Cambridge-Hackspace/spaces-toolguard-device/hardware/carrier/carrier.kicad_pcb

## KiCad design hardware/carrier/carrier.kicad_pcb (2026-11-12)

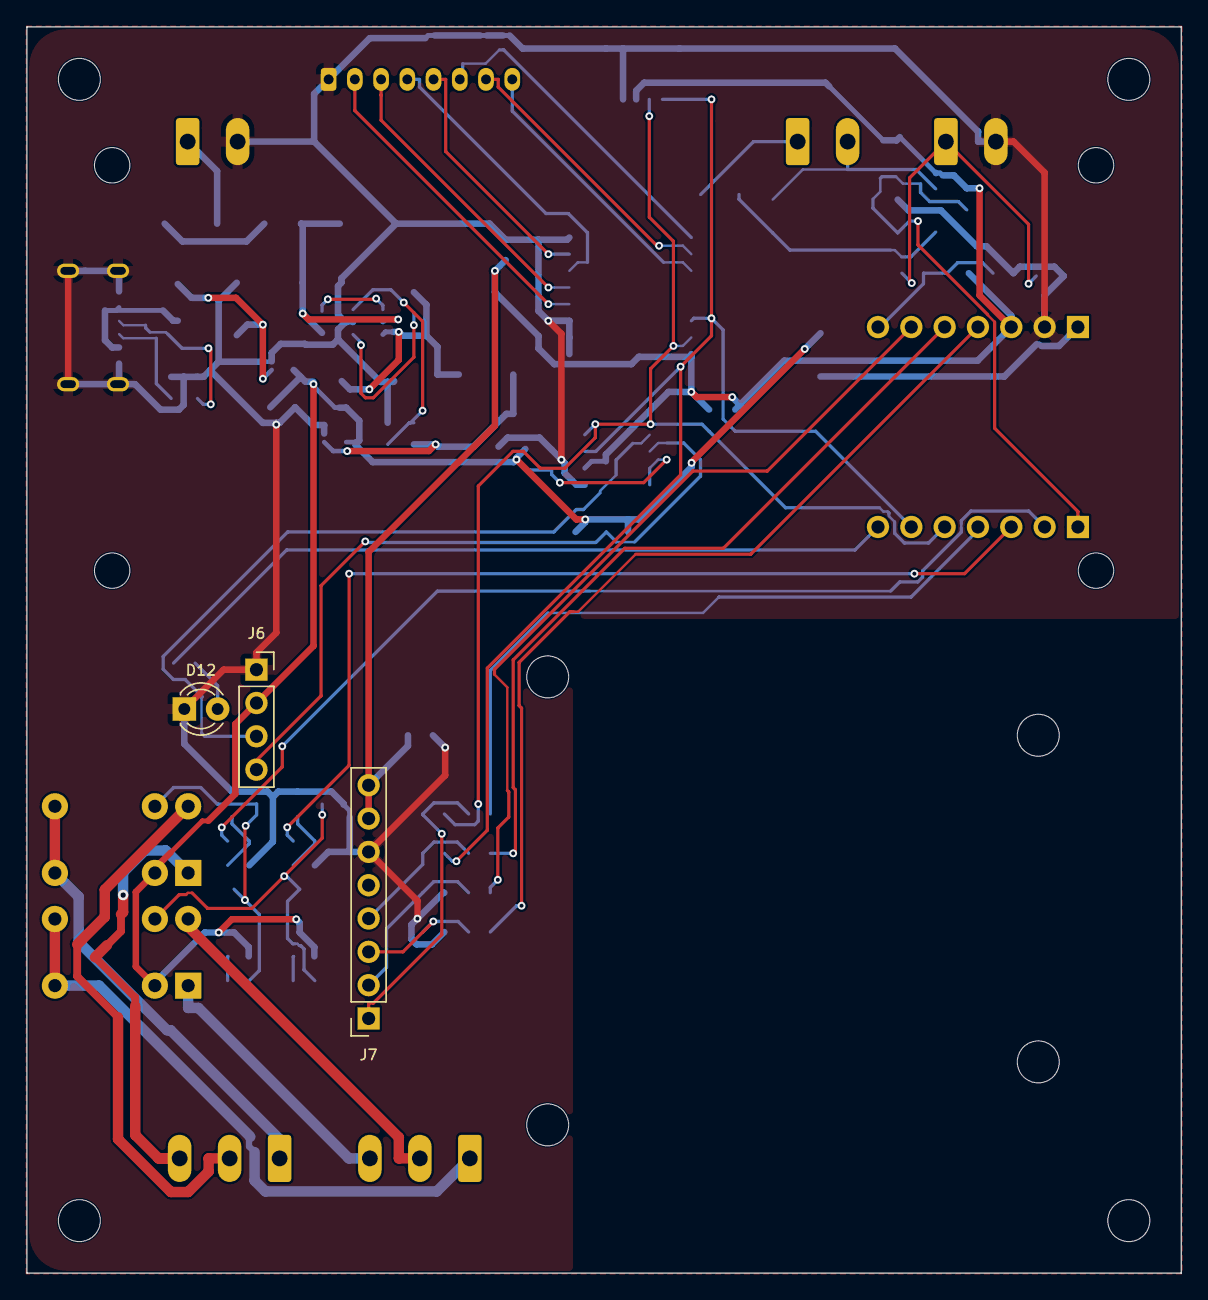
[picture p3: board carrier.kicad_pcb from above]

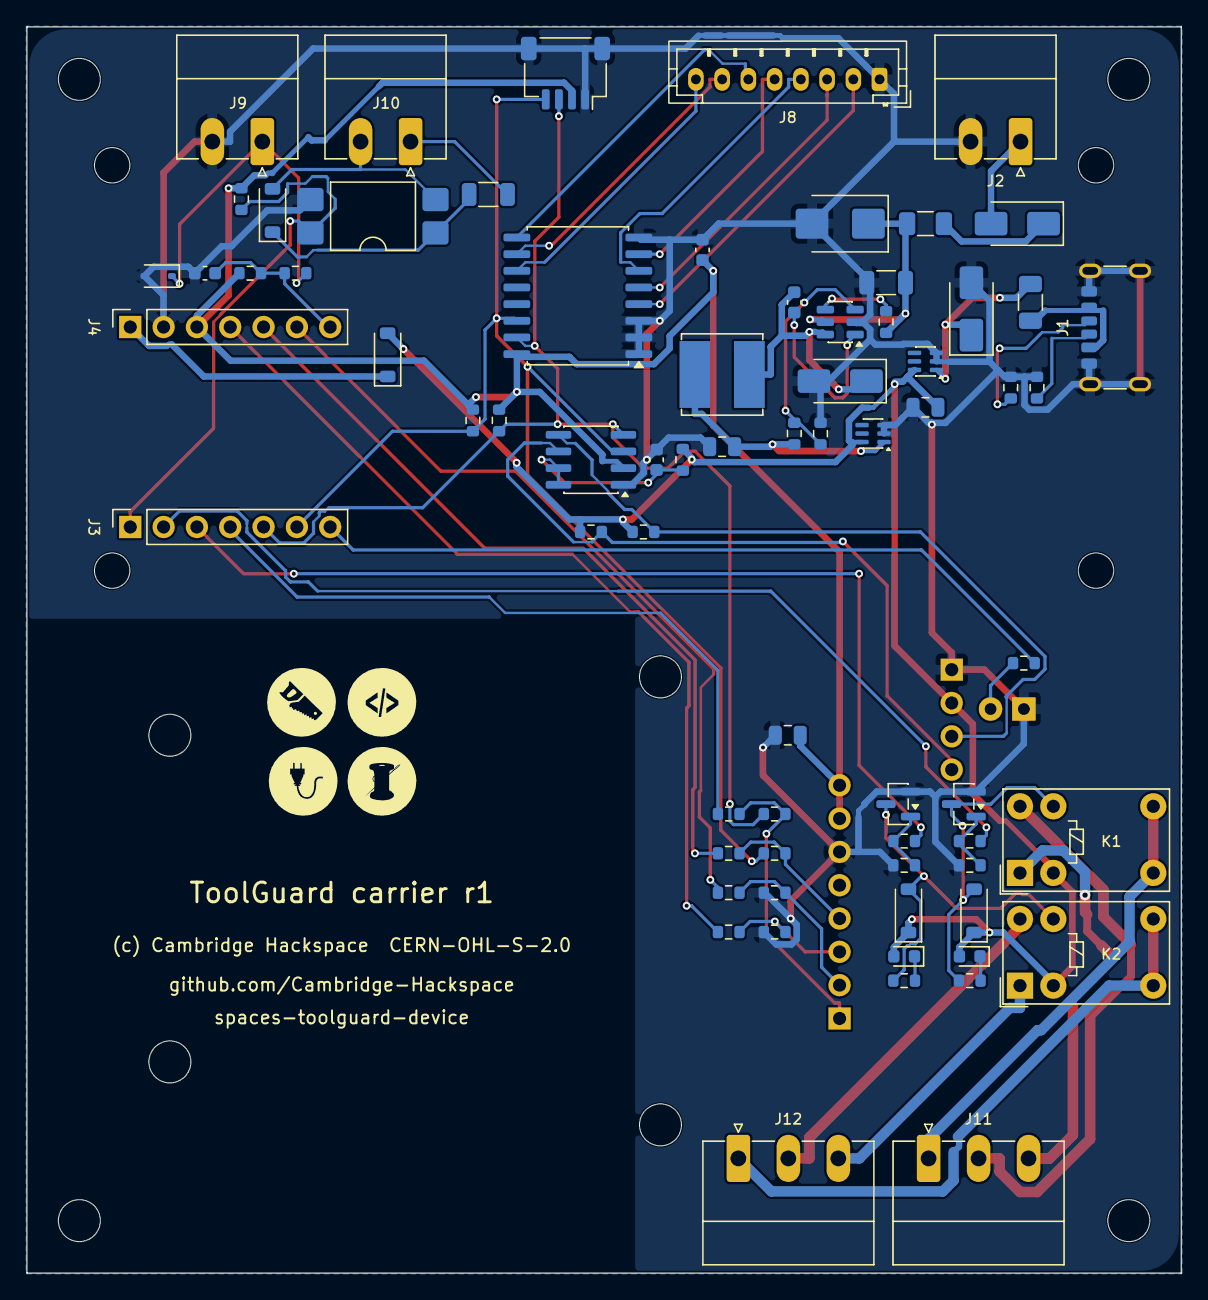
[picture p4: board carrier.kicad_pcb from below]

Board: 2 copper layers, 88.0 x 95.0 mm, 86 parts (71 on the bottom side), 58 nets.

Parts:
C1: 2.2uF 100V; C_1206_3216Metric
C2, C5, C7, C8: 100nF; C_0603_1608Metric
C3: 10uF 16V; C_0805_2012Metric
C4, C6: 10uF 10V; C_0805_2012Metric
D1: 5V standoff; D_SMA
D2, D4: 100V 1A; D_SMA
D3: 40V standoff; D_SMB
D5: 40V 1A; D_SOD-123
D6: 3.3V ESD; D_SOD-323
D7, D8, D10: 1N4148W; D_SOD-123
D9, D11: green; LED_0603_1608Metric
D12: red, 3 mm; LED_D3.0mm
F1: 1.1A hold, 6V+; Fuse_1206_3216Metric
F2: 500mA 63V; Fuse_1206_3216Metric
H1, H2, H3, H4, H9, H10, H11, H12: MountingHole; MountingHole_3.2mm_M3
H5, H6, H7, H8: MountingHole; MountingHole_2.7mm_M2.5
J1: USB_C_Receptacle_PowerOnly_6P; USB_C_Receptacle_GCT_USB4125-xx-x_6P_TopMnt_Horizontal
J2, J9, J10: Conn_01x02; PhoenixContact_MC_1,5_2-G-3.81_1x02_P3.81mm_Horizontal
J3, J4: Conn_01x07; PinSocket_1x07_P2.54mm_Vertical
J5: Conn_01x04_MountingPin; JST_SH_SM04B-SRSS-TB_1x04-1MP_P1.00mm_Horizontal
J6: Conn_01x04; PinSocket_1x04_P2.54mm_Vertical
J7: Conn_01x08; PinSocket_1x08_P2.54mm_Vertical
J8: Conn_01x08; JST_PH_B8B-PH-K_1x08_P2.00mm_Vertical
J11, J12: Conn_01x03; PhoenixContact_MC_1,5_3-G-3.81_1x03_P3.81mm_Horizontal
K1, K2: G5V-1; Relay_SPDT_Omron_G5V-1
L1: 22uH, Isat >= 1.6A; L_Bourns_SRN6045TA
Q1, Q2: AO3400A; SOT-23
R1, R2: 5.1k; R_0603_1608Metric
R3, R24, R27: 100k; R_0603_1608Metric
R4: 57.6k 1%; R_0603_1608Metric
R5: 10k 1%; R_0603_1608Metric
R6, R7, R9, R10: 4.7k; R_0603_1608Metric
R8: 200k; R_0603_1608Metric
R11, R12, R13, R14, R15, R16, R17, R18: 0R; R_0603_1608Metric
R19, R29: 1k; R_0603_1608Metric
R20, R22: 10k; R_0603_1608Metric
R21: 2.2k; R_1206_3216Metric
R23, R26: 100R; R_0603_1608Metric
R25, R28: 2.2k; R_0603_1608Metric
U1: LV2862XDDC; SOT-23-6
U2, U3: LM66100DCK; SOT-363_SC-70-6
U4: PCA9306; SOIC-8_3.9x4.9mm_P1.27mm
U5: PCF8574T; SOIC-16W_7.5x10.3mm_P1.27mm
U6: LTV-817S; SMDIP-4_W9.53mm

Connections:
+3V3: C6.1, C7.1, J4.3, J5.2, J7.7, J7.8, R6.2, R7.2, R20.2, R22.2, U4.2, U5.16
+5V: C4.1, D5.2, D8.1, D9.2, D10.1, D11.2, J6.2, K1.2, K2.2, R8.2, R9.2, R10.2, U2.6, U3.6
+5V2_BUCK: C3.1, L1.2, R4.1, U3.1
BUCK_FB: R4.2, R5.1, U1.3
BUCK_SW: C2.2, D4.1, L1.1, U1.6
CS: J3.4, R15.2
GND: C1.2, C3.2, C4.2, C5.2, C6.2, C7.2, C8.2, D1.2, D3.2, D4.2, D6.2, D12.1, J1.A12, J1.B12, J1.SH, J2.2, J4.2, J5.1, J5.MP, J6.1, J7.6, J8.1, J9.2, Q1.2, Q2.2, R1.2, R2.2, R5.2, R13.2, R14.2, R24.2, R27.2, U1.2, U2.2, U2.3, U3.2, U3.3, U4.1, U5.1, U5.2, U5.3, U5.8, U6.3
JOY_DOWN: J8.3, U5.5
JOY_LEFT: J8.4, U5.6
JOY_MID: J8.6, U5.9
JOY_RIGHT: J8.5, U5.7
JOY_RST: J8.8, U5.11
JOY_SET: J8.7, U5.10
JOY_UP: J8.2, U5.4
K1_COIL: D8.2, K1.9, Q1.3, R25.2
K1_COM: J11.1, K1.5, K1.6
K1_GATE: Q1.1, R23.2, R24.1
K1_LED: D9.1, R25.1
K1_NC: J11.3, K1.1
K1_NO: J11.2, K1.10
K2_COIL: D10.2, K2.9, Q2.3, R28.2
K2_COM: J12.1, K2.5, K2.6
K2_GATE: Q2.1, R26.2, R27.1
K2_LED: D11.1, R28.1
K2_NC: J12.3, K2.1
K2_NO: J12.2, K2.10
LIGHT: J3.7, R29.1
LVL_EN: C5.1, R8.1, U4.7, U4.8
MISO: J4.5, R16.2
MOSI: J4.4, R18.2
unnamed: J1.A5, R1.1
unnamed: J1.B5, R2.1
unnamed: R3.2, U1.4
unnamed: C2.1, U1.1
unnamed: D12.2, R29.2
RC_MISO: J7.4, R12.1, R16.1
RC_MOSI: J7.3, R14.1, R18.1
RC_SCK: J7.2, R13.1, R17.1
RC_SDA: J7.1, R11.1, R15.1
RELAY: J3.2, R23.1
SCL: J3.6, J5.4, R7.1, R12.2, U4.3, U5.14
SCLK: J4.6, R17.2
SCL_5V: J6.4, R10.1, U4.6
SDA: J3.5, J5.3, R6.1, R11.2, U4.4, U5.15
SDA_5V: J6.3, R9.1, U4.5
SENSE: J3.1, R22.1, U6.4
SENSE_LED: D7.1, R21.2, U6.1
SENSE_N: D7.2, J10.2, U6.2
SENSE_P: J10.1, R21.1
STOP: C8.1, J4.7, R19.2, R20.1
STOP_IN: D6.1, J9.1, R19.1
STRIKE: J3.3, R26.1
VBUS: F1.1, J1.A9, J1.B9
VBUS_F: D1.1, F1.2, U2.1
VIN: C1.1, D3.1, F2.2, R3.1, U1.5
VIN_RAW: D2.2, J2.1
VIN_RP: D2.1, F2.1
XIAO_5V: D5.1, J4.1
