Cambridge-Hackspace/spaces-toolguard-device/(commit log)

2026-11-07 the ESP32-C5 as a compile-only target (#15)
    Same family and triple as the C6 -- riscv32imac-esp-espidf, plain upstream
    nightly, ESP-IDF v5.5.3, which this repo already pins -- with the one
    difference that matters in a hackspace: 5 GHz Wi-Fi. Every tool box on
    2.4 GHz is another talker in the band the Zigbee mesh shares; a C5 box is out
    of that contest. It also has more GPIO than the C6, though the pin map below
    spends all of it on the DevKitC-1.
    The C5 gets the standing the C3 and S3 have: a cfg-gated pin map, a
    check-cfg entry, a board::CHIP arm, a CI matrix row that lints and builds
    it, a column in the documented pin table, and the README's build line.
    THE TRIPLE IS THE C6's. embuild map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
2026-11-08 an update waits while anything is open
    spaces-device-espidf refuses a firmware update while a session is open, but
    only when the firmware says so, and this one never did: it drives its own
    loop over Reader rather than spaces-device-espidf's run(), which is where
    set_in_session is called. So a push could restart a box mid-cut, dropping
    the tool's power on a box that switches it, and the box came back up knowing
    nothing of the session it had opened.
    The core now says when something is open or nothing is, as
    Action::InSession, emitted on change, and the firmware hands it to the
    update guard. "Open" is a question out to the edge, a session, or the tool
    output on. The last is what a plug has, si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
2026-11-08 an update has to get back to the broker, or it is undone
    A new image is on probation until it gets back to what the old one had, and
    the broker is one of those milestones. spaces-device-espidf reaches and
    loses it only in its own run(), which this firmware does not use, so no
    image of it ever reached the broker as far as the update guard knew. An
    image that joined Wi-Fi but never reached the edge's broker passed
    probation, where it should have been rolled back after three minutes.
    The loop now reaches update::BROKER on every connect and loses it on every
    disconnect, as run() does.
    Wiring in main.rs only: the core is not involved, and the firmware crate
    builds only for an ESP target, so the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
    [main.rs]
2026-11-08 the outputs are driven low before anything else
    The relay and strike pins were opened, and driven low, only after boot()
    returned: after Wi-Fi had joined and the device had registered, and never
    while the setup portal was open. Until then each was an input at its reset
    state, floating or weakly pulled, and a relay driver that reads a floating
    input as on could energize the tool, or release a door, for seconds or
    indefinitely.
    Both are now opened and driven low first, whatever the settings say. An
    output the settings do not use keeps its driver held all the same, since
    dropping it resets the pin and lets it float again; the settings still
    decide which of them the core may drive.
    On the C3 t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
    [main.rs]
2026-11-08 a broker that cannot be set up restarts the box, as other failures do
    broker::connect failing returned from main with `?`. That ends the program
    but not the board: it stayed on the network serving updates, with nothing
    reading cards, sending heartbeats or drawing the panel, and nothing saying
    why. Every other fatal path logged, set the light to failed, waited thirty
    seconds and restarted.
    They all go through give_up() now, which also puts a screen up when there is
    a panel: "Broker failed / see /log" for this one, "Reader fault" as before
    for the RC522. A blank broker address cannot get this far, since the shared
    setup fields require it; a malformed one can, and now restarts every thirty
    sec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
    [main.rs]
2026-11-08 the panel knows when Wi-Fi is gone
    health() always said Wi-Fi was up, on the reasoning that boot() does not
    return until it has joined. True at boot; but when the network went later,
    the broker dropped with it and the diagnostic screen said "No edge", naming
    the wrong half -- the screen exists to say which half is missing.
    The firmware now listens for the station joining and losing its network on
    the system event loop, and feeds that into the loop's channel beside the
    broker's events, so the panel is told both in the order they happen. If the
    subscription cannot be made, it says so in the log and assumes Wi-Fi is up,
    as before.
    The fix is wiring in main.rs and broker.rs, which build only f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
    [main.rs, reader.rs]
2026-11-08 settings are read in the core, and tested
    What the setup page's words mean was decided in toolguard-fw, which builds
    only for an ESP target, so none of it was tested: what a typo reads as, what
    a blank defaults to, which roles a combination registers, and that a second
    tap defaults on only where nothing else can stop a session. It is pure code
    over strings, so it moves to toolguard_core::settings and reads through a
    lookup. The firmware keeps the setup page's fields and reads the store;
    anything that could not be read comes back as warnings for it to log, since
    the core has no logger.
    One bug found on the way: "Bridge gaps" and "Ignore blips" were cast to u32
    with `as`, so a large enough va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
    [lib.rs, main.rs, settings.rs]
2026-11-08 a box says when its roles changed after registration
    The roles are derived from the settings and sent once, at registration; a
    registered device never sends them again. So changing "Has a card reader",
    "Switches the tool", "Senses the machine" or "Drives a latch" on a working
    box changed what it did and not what the platform had it as: a reader told
    it now switches the tool drove its relay, could never be bound in `power`,
    and was never leased, with nothing to say why.
    The firmware now records the roles under reg_roles whenever it knows they
    have just been sent (a box registering on this boot) and compares them at
    every later boot. If the settings claim different roles, it says so in the
    lo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
2026-11-08 the panel is sent only what it can draw
    A screen cut each line to sixteen characters and left what an HD44780
    cannot render to the shell, which printed it as it was. A reason with an em
    dash, a curly quote or an accent went to the panel as its UTF-8 bytes, each
    drawn as whatever the character ROM holds there: garbage, and more columns
    of it than the line had characters.
    Each character is now mapped before the cut: printable ASCII from space to
    `}` stands, except `\` and `~`, which the common A00 ROM draws as a yen sign
    and an arrow; everything else is a `?`. A line is then plain ASCII, so
    sixteen characters is sixteen columns.
    Tests: accents, an em dash and a curly quote each become one `?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
2026-11-08 how usage is measured is a setting, in the core
    The sense input was one thing: a level, active low or high, read once a
    pass. On the laser that is wrong two ways, and the core now has the pieces
    to get both right; the firmware is wired to them in the next commit.
    - Firing on L-ON1 is pulses of a few milliseconds (#9). Read once every
    75 ms, most are never seen. Usage measured by "pulses" counts a pass as
    working if the input is asserted or pulsed at all since the last read,
    which the firmware is to latch by interrupt. The blip and gap filters stay
    downstream and unchanged, so a run of pulses is joined into one stretch and
    a lone glitch under the blip filter is still rejected.
    - Wi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
    [lib.rs, reader.rs, sense.rs, settings.rs]
2026-11-08 the firmware measures usage as configured: pulses by interrupt, and a powered input
    The firmware half of the previous commit.
    - Pulses (#9): with "Usage measured by" pulses, the sense pin gets an
    interrupt on the edge into its asserted level, which only sets an atomic.
    The loop takes the flag each pass, re-arms the interrupt (the driver
    disables it each time it fires), and hands the core a Reading: asserted
    now, pulsed since the last pass, and the powered input if there is one.
    A pulse of a millisecond between two 75 ms passes is no longer lost.
    - A powered input (#8), on GPIO7 on the C6 (an edge pin on the Super Mini,
    not strapping, and clear of the ADC pins an analog source wo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
    [main.rs, settings.rs]
2026-11-09 spaces-firmware v0.8.0: the shared loop and CS:S's wire, no change in behaviour (#18)
    From v0.4.0 to v0.8.0 of spaces-device and spaces-device-espidf: the device
    trait and shared loop (v0.7.0), and the wire as CS:S's css_wire (v0.8.0).
    This box keeps its own loop for now; moving onto run() is the next commits.
    The one test fix is the reply shape: css_wire requires `reason`, and the
    door test's strike reply lacked it, so it no longer parsed and read as a no.
    77 core tests, clippy (host and C6) and the C6 build pass.
    [reader.rs]
2026-11-09 the box runs on spaces-firmware's loop, and broker.rs is gone (#18)
    This box ran its own copy of the loop in broker.rs, because the library's
    run() drove only a Module, and the copy missed what the library's loop did
    besides -- holding an update during a session, the BROKER milestone, Wi-Fi
    state -- until each was patched back in by hand (#1, #2, #5). With the
    Device trait (spaces-firmware #8) the library's run() drives this box too,
    and does all three once, for every device.
    Core: Reader implements Device, with Input for a card, the stop button, a
    sense reading, the resting-screen notice and the clock. The session is a
    query, Reader::in_session(), instead of an action: Action::InSession is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
    [device.rs, lib.rs, main.rs, reader.rs]
2026-11-09 the stop button uses spaces-device's debouncer (#18)
    toolguard-core's StopButton was a second debouncer beside spaces-device's
    input::Debounced, which every device now shares (spaces-firmware #6). The
    stop button is a Debounced::button(): a press counts once the contact has
    settled for 30 ms, and holds for 250 ms, so no bounce or lingering finger
    is a second stop. StopButton (a 50 ms settle, held until release) and its
    four tests are deleted; Debounced is tested in spaces-device. The README's
    crate table says what toolguard-core now is.
    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
2026-11-09 version 0.3.0, with the tag
    A version bump has no behaviour to test; the core suite was run once more
    at this version so the tag is cut from a green tree.
2026-11-09 spaces-toolguard-device: the repo holds the boards too, under CERN-OHL-S
    The repository is renamed from spaces-toolguard-firmware, because it is
    about to hold the boards the firmware runs on as well as the firmware.
    The pin map has to agree in two places, `board.rs` and a board's
    schematic, and keeping both in one repo means a change to either lands
    in one pull request and a test can hold them together.
    - Cargo.toml's `repository`, the README's title and the boot log line
    take the new name. GitHub redirects the old URLs, so nothing else has
    to move today.
    - hardware/ is new and licensed CERN-OHL-S-2.0. AGPL is a software
    licence and says nothing useful about a board someone manufactur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
2026-11-09 C3: the strike moves off U0TXD, which the boot ROM drives (#20)
    The C3 map put the strike on GPIO21, U0TXD, on the reasoning that the
    Super Mini's console is native USB so UART0 is free. It is not free at
    boot: by default (EFUSE_UART_PRINT_CONTROL = 0) the ROM prints its
    messages on UART0 regardless of the application's console, and the
    ESP32-C3 datasheet (v2.4, table 2-1) lists U0TXD as output-enabled with
    a pull-up after reset. A latch driver there would pulse the door open on
    every power-up, crash and update, before the firmware drives the pin
    low.
    - strike is now GPIO4 (MTMS): input-enabled, no pull at reset, not
    driven by the ROM, so the driver's gate pull-down holds it off.
    - The RC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
    [main.rs, pinmap.rs]
2026-11-09 rc522.rs says exactly which part is GPL-3.0 (#14)
    The header said both that the file was "adapted from" nfc-522's
    src/nfc.rs (GPL-3.0, with a second copyright) and that "what is taken is
    the shape rather than the text", which cannot both be the whole story.
    Compared line by line against nfc-522's nfc.rs: Reader::poll's
    REQA / SELECT / HLTA / STOP-CRYPTO1 sequence and the two comments
    explaining it are close paraphrases of nfc-522's poll(). The rest is
    not: the bring-up, the mode-3 SPI configuration, the version-register
    checks and their diagnostics, and to_hex (same job, different code).
    Probing by version register and the same-UID cooldown are ideas taken
    without the text.
    So the header n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
2026-11-09 Pins, stale comments, and the controller's safety inputs in the docs (#12)
    Pins (checked against the ESP32-C6 datasheet):
    - GPIO4-7 were called "strapping, JTAG and flash-adjacent" and treated
    as unavailable, while the C6 map already uses GPIO7. 4 and 5 are
    strapping pins (MTMS, MTDI), 6 and 7 are JTAG (MTCK, MTDO), and flash
    is GPIO24-30. They are usable with care: nothing driving 4 or 5 at
    reset, and no must-stay-off output on 6, which is pulled up after
    reset. board.rs and INSTALLING.md section 5 say so.
    - "SPI occupies all of ADC1 (GPIO0-6)" was wrong: SPI holds 0-3, so
    4-6 remain, which is where an analog sense input would go (#10).
    - "A C6 Super Mini is full" now says the f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
    [board.rs, main.rs, rc522.rs, screen.rs]
2026-11-09 CI: the Rust cache is keyed by chip, so the C5 job never gets the C6's
    Swatinem/rust-cache keys on the job id, which is `riscv` for every entry
    in the RISC-V matrix, and the C5 and C6 share a target triple. The C5
    job on PR #26 restored a target/ the C6 job had saved, with
    esp-idf-sys's build directory configured for esp32c6, and CMake refused:
    "CMAKE_TOOLCHAIN_FILE 'toolchain-esp32c6' does not match currently
    selected IDF_TARGET 'esp32c5'". Which job saved last decided whether the
    C5 build passed, which is why it passed on earlier PRs.
    `key: ${{ matrix.mcu }}` gives each chip its own cache. The ESP-IDF
    cache (.embuild) was already keyed by chip.
    No test: CI configuration. The proof is thi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
2026-11-09 Pin maps by board, from one TOML file per board (#25, step 1)
    The firmware chose pins by chip (`cfg(esp32c6)` tuples in main.rs), and
    the XIAO carrier and the DevKitC-1 are both C5s. This moves each map to
    toolguard-fw/boards/<board>.toml and chooses the board with `BOARD`, as
    the chip is chosen with `MCU`. No behaviour changes: every board file
    holds exactly the pins its chip had (checked against the old main.rs
    tuples), and each chip's default board is the one it built before.
    - build.rs reads BOARD (default per MCU: c6-supermini, c5-devkitc1,
    c3-supermini, s3-devkitc1), refuses an unknown board, a board for
    another chip, a missing required role, an unknown role, and a GPIO
    named tw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
    [board.rs, build.rs, main.rs, pinmap.rs]
2026-11-09 The XIAO C5 carrier board, with its reader found on I2C (#19, #23)
    The carrier board (#25) takes a socketed Seeed XIAO ESP32-C5, puts the
    LCD, a converted RC522 and the joystick's expander on one I2C bus, wires
    the stop button normally closed and has a plain panel LED. This is the
    firmware for it, on spaces-firmware v0.9.0.
    The shared bus and the reader (#23):
    - bus.rs makes the I2C driver once and hands each part a RefCellDevice
    (embedded-hal-bus); everything on it runs on the loop's one thread.
    - The LCD is found through spaces_device::i2c and initialised AT THE
    ADDRESS IT WAS FOUND: CharacterDisplayPCF8574T::new used the crate's
    default address whatever the scan found, so a backpac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
2026-11-11 The carrier board's schematic, as SKiDL, checked against the firmware (#25)
    hardware/carrier/ is the ToolGuard carrier's schematic: a socketed XIAO
    ESP32-C5 and everything around it, one design populated per box (#24).
    Why SKiDL and not atopile: atopile 0.15 needs a signed-in hosted service
    to pick any part, even one named by LCSC number, and says its CLI is in
    maintenance mode, replaced by a hosted app. A board that only builds
    while logged in to a service is a poor fit for CERN-OHL-S's Complete
    Source. SKiDL (MIT, pinned 3.0.0 in uv.lock) is Python and offline, and
    builds from KiCad 10's own symbol and footprint libraries.
    carrier.py, by block: USB-C power in (power only: 5.1 k on both C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
    [build.rs, carrier.py, check.py]
2026-11-11 carrier: ignore KiCad's per-user files, and say where the layout lives
    The layout (carrier.kicad_pcb) and project (carrier.kicad_pro) go in
    hardware/carrier/ next to carrier.py and carrier.net. KiCad's backups,
    local view state (.kicad_prl), footprint cache and lock files are
    ignored. The README says the empty carrier.kicad_sch KiCad makes stays
    empty: carrier.py is the schematic, and the netlist is the only way it
    reaches the layout.
    No test: ignore rules and documentation.
2026-11-11 carrier: the KiCad project and an empty board, with fab design rules
    carrier.kicad_pro and carrier.kicad_pcb, made through KiCad 10.0.8's own
    Python API (pcbnew) so the settings are KiCad's, not hand-written JSON:
    two copper layers, 1.6 mm, and design rules comfortably inside PCBWay's
    standard 2-layer process -- 0.15 mm minimum track and clearance, 0.3 mm
    minimum drill, 0.6 mm vias with a 0.15 mm annular ring, 0.25 mm hole
    clearance, 0.3 mm copper-to-edge; the default net class 0.25 mm tracks,
    0.2 mm clearance, 0.6/0.3 mm vias.
    The board is empty on purpose: footprints arrive by Import Netlist
    (carrier.net) in the KiCad GUI, which links each to its part by its
    fixed tag. Placing them by scr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
    [carrier.kicad_pcb]
2026-11-11 carrier: every footprint is explicit; the 1N4148Ws are SOD-123
    The first netlist import put three 1N4148W diodes (both relays' flyback
    diodes and the sense input's reverse diode) on through-hole DO-41
    footprints: carrier.py named no footprint for them, and KiCad's 1N4148W
    symbol defaults to D_DO-41 although the part is SOD-123. check.py did
    not catch it -- a DO-41 has pads 1 and 2 too -- and a footprint-filter
    check would not have either: SKiDL's list for the symbol includes the
    DO-41.
    So part() now refuses to make a part without an explicit footprint: a
    symbol's default is not a choice. The diodes are Diode_SMD:D_SOD-123,
    and the opto and relays name the footprints they already had.
    Also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
    [carrier.py]
2026-11-11 carrier: holes for the LCD and the RC522, and a through-hole status LED
    - Four M2.5 holes for the LCD's standoffs (a 1602's holes are usually on
    75 x 31 mm; M2.5 also takes the small-holed variants) and two M3 holes
    for the RC522 module, to be used with nylon standoffs since metal near
    the antenna detunes it. They are in the netlist because the import
    deletes footprints that are not; their positions are the layout's,
    measured against the real modules.
    - The status LED is a 3 mm through-hole part (LED_THT:LED_D3.0mm, pad 1
    K as on the symbol) on the front, so it shows through the panel while
    every SMD part stays on the back for one-sided assembly.
    - The README gains the layout g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
2026-11-12 carrier: the LCD's and the RC522's measured hole patterns
    From caliper measurements of the Hackspace's own modules, centres worked
    out from edge-to-edge gaps: the QAPASS 1602 on 75.0 x 30.9 mm (the
    standard pattern), and the blue RC522's four holes, which assume 3.2 mm
    holes and a level bottom row; the README says how to confirm them. For
    placing the hole footprints in the layout.
    No test: documentation.
2026-11-12 carrier: first placement and routing, DRC clean but for silkscreen
    The first full layout, 88 x 95 mm, done through KiCad 10's Python API
    and Freerouting 2.5.0 (run on Java 27), checked with kicad-cli.
    Front, facing the panel: the LCD across the top on its standoffs
    (75.0 x 30.9 mm), the RC522 landscape at the bottom right with its
    antenna to the right edge, the status LED and the LCD's cable connector
    at the bottom left. Back: field terminals, the joystick and Qwiic
    connectors along the top edge; USB-C power and the buck at the left
    edge; the XIAO socketed at the right edge with its USB-C reachable; the
    I2C parts between; the relays and their drivers above their terminals
    at the bottom. A r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
    [carrier.kicad_pcb]
2026-11-12 carrier: the Cambridge Hackspace logo on the back silkscreen
    The cutout logo (icons only), 14 mm across, above the licence text in
    the RC522 antenna's copper-free area on the back. Added as board
    graphics rather than a footprint: a netlist import deletes footprints
    that are not in the netlist, and never touches board graphics. Its SVG
    paths were flattened, combined so the icons are cut out of their
    circles, and mirrored to read correctly from the back.
    DRC unchanged: 0 unconnected, no errors; the same 46 silkscreen
    warnings as before. The finest strokes (the spool's thread, the saw's
    teeth) are near silkscreen's resolution at this size.
    [carrier.kicad_pcb]
2026-11-12 carrier: a build guide, in Quarto, with figures drawn from the board
    hardware/carrier/guide/ renders to PDF (through Typst) and to a single
    HTML page with `quarto render`. It covers what to fit for each box
    configuration (#24), choosing the reader's I2C or SPI links, the 7-60 V
    input, the through-hole soldering order, the mechanical stack (standoffs,
    nylon for the RC522), the field wiring, building and setting up the
    firmware, and a bring-up checklist. What the installation guide already
    says -- safety, the signal on a Ruida controller, the setup page, the
    platform -- it links to rather than repeats.
    The figures are generated from carrier.kicad_pcb by figures.py: each
    side of the board with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
2026-11-12 CI: KiCad's PPA calls its library packages kicad-symbols and kicad-footprints
    The carrier check's first run failed installing kicad-library-symbols
    and kicad-library-footprints: those are the PPA's source package names;
    apt names the binaries kicad-symbols and kicad-footprints.
    No test: CI configuration; the PR's next run is the proof.
2026-11-12 Carrier: silkscreen clean (DRC 0 violations, was 46 warnings)
    The surface-mount parts' reference labels move to the Fab layers: the fab
    places them from the pick-and-place file, so their labels belong on the
    assembly drawing, not on the copper and each other. Through-hole parts,
    soldered by hand, keep theirs on the silkscreen; the four that collided
    (K1, K2, J9, J10) move to the nearest clear spot.
    Layout-only, no circuit change; DRC is the check (kicad-cli pcb drc: 0
    violations, 0 unconnected). Guide render of the back regenerated.
    [carrier.kicad_pcb]
2026-11-12 Carrier: fab.py writes the order files (Gerbers, drill, BOM, placement)
    Gerbers and drill files, zipped, for the bare board; and per variant a
    BOM in PCBWay's columns, the centroid file, the hand-solder list and the
    not-fitted list. Two variants: usb (every box but (d)) and vin (box (d),
    the 7-60 V input fitted). The SPI reader links are never fitted.
    It works on a copy of the board: the netlist import keeps the schematic's
    DNP as a field but not as KiCad's flag, so the copy gets the flags for its
    variant, and the drill/place origin at the bottom-left corner. The source
    board is unchanged.
    Outputs go to fab/, git-ignored. Checks itself: every fitted part is
    either SMD or THT, and the place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
2026-11-12 Carrier: part numbers for the parts given only by rating
    F1 (polyfuse) Bourns MF-NSMF110-2: 1.1 A hold, 6 V, 1206
    F2 (VIN fuse) Littelfuse 0466.500NR: 500 mA, 63 V AC/DC, 1206
    L1 (buck) Bourns SRN6045TA-220M: 22 uH, Isat 3.3 A (needs 1.6 A);
    the footprint's own series. Not the SRN6045 (no TA): 1.9 A.
    D9, D11 Lite-On LTST-C191KGKT: green 0603, Vf 2.0 V typ, 2.4 V
    max; ~1.3 mA through 2.2k from 5 V
    Set in carrier.py, and as MPN fields on the board's footprints (the same
    values a netlist re-import would bring). Every assembled part now has an
    MPN except generic resistors and capacitors; fab.py reports none missing.
    Part data, no cir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
    [carrier.kicad_pcb]
2026-11-12 Carrier: H11 and H12 match the schematic, and check.py makes sure of it
    The RC522's two right-hand standoff holes were on the board under the
    right IDs but as the placement script had made them: a footprint ID with
    no library ("MountingHole_3.2mm_M3"), no tag, note or description, and
    excluded from the BOM and placement. KiCad's "Update PCB from Schematic"
    would have taken them for a different footprint and replaced them. They
    now carry what the netlist says, as their twins H9 and H10 do. Same
    position, DRC 0 violations.
    check.py gains a fourth check: every part is on the layout under the ID
    the netlist gives it, with the same footprint, reference and tag, not
    excluded from BOM or placement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
    [carrier.kicad_pcb]
2026-11-12 Carrier guide: figures are built in CI, not committed; the PDF on each tag
    The guide's figures are generated from the board by figures.py, so they
    are build outputs: they leave git (guide/figures/ is ignored) and the
    guide job builds them before rendering. That job now installs KiCad 10
    itself (its Python module and kicad-cli, not only the libraries) and runs
    the 3D renders under xvfb, as they need OpenGL.
    CI also runs on v* tags, and on a tag the guide job attaches the PDF to
    the tag's GitHub release (creating the release if there is none yet), as
    carrier-build-guide-<tag>.pdf.
    The figures were the only generated files tracked (lockfiles and the board
    are sources). CI configuration and do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
2026-11-12 Carrier: H11 and H12's labels hidden, as every other hole's is
    The placement script left them visible on the front silkscreen, where
    they sit under the RC522 and print to no purpose. Silkscreen only; DRC
    0 violations. Untestable in isolation beyond DRC.
    [carrier.kicad_pcb]
2026-11-13 version 0.4.0, with the tag
    The firmware reports this version (main.rs, and to the update service).
    A version bump: nothing to test in isolation; host tests and fmt pass,
    and CI builds every board before the tag goes on.
