Cambridge-Hackspace/spaces-toolguard-device/(notices)

Notices in the files:
hardware/carrier/carrier.kicad_pcb:
(c) Cambridge Hackspace CERN-OHL-S-2.0
